themkoi/esp32-alarm-clock/clock-pcb/sub-boards/side-board/side-board.step

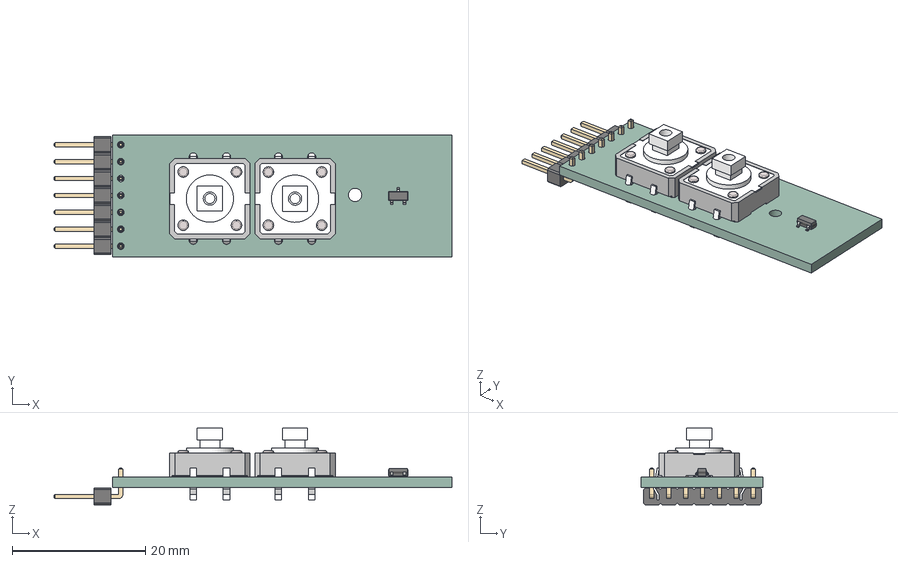
[picture p1: CAD file, 2025-02-12]
clock-pcb/sub-boards/side-board/side-board.step
59.8 x 18.3 x 11.5 mm
B3F-4055 x 2
SOT-23-3
PinHeader_1x07_P254mm_Horizontal
side-board_PCB
