themkoi/esp32-alarm-clock/clock-pcb/sub-boards/top-board/top-board.step

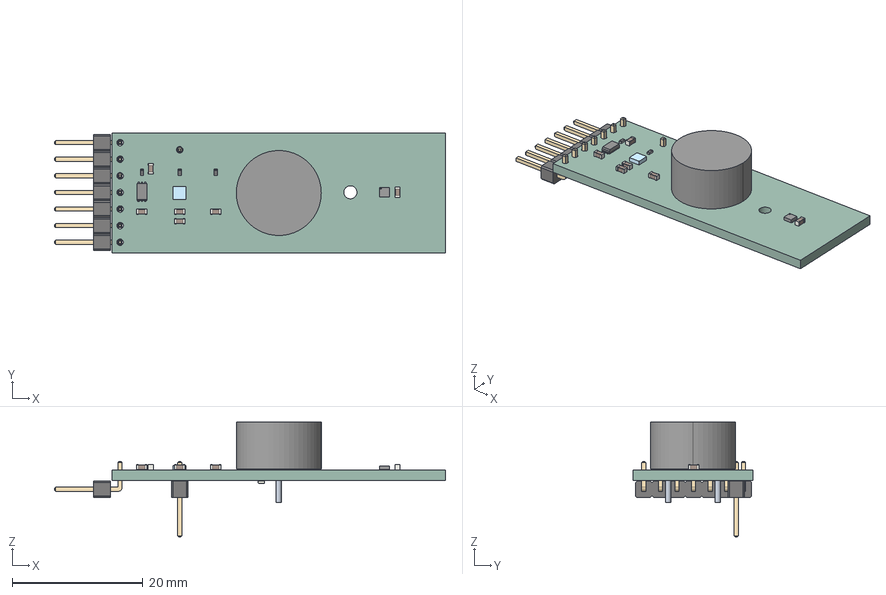
[picture p2: CAD file, 2025-02-12]
clock-pcb/sub-boards/top-board/top-board.step
59.8 x 18.3 x 17.5 mm
R_0402_1005Metric x 4
C_0603_1608Metric x 6
ASSEMBLY x 2
BH1750FVI-TR
PinHeader_1x01_P254mm_Vertical
PinHeader_1x07_P254mm_Horizontal
top-board_PCB
