themkoi/esp32-alarm-clock/clock-pcb/sub-boards/touch-pad/touch-pad.step

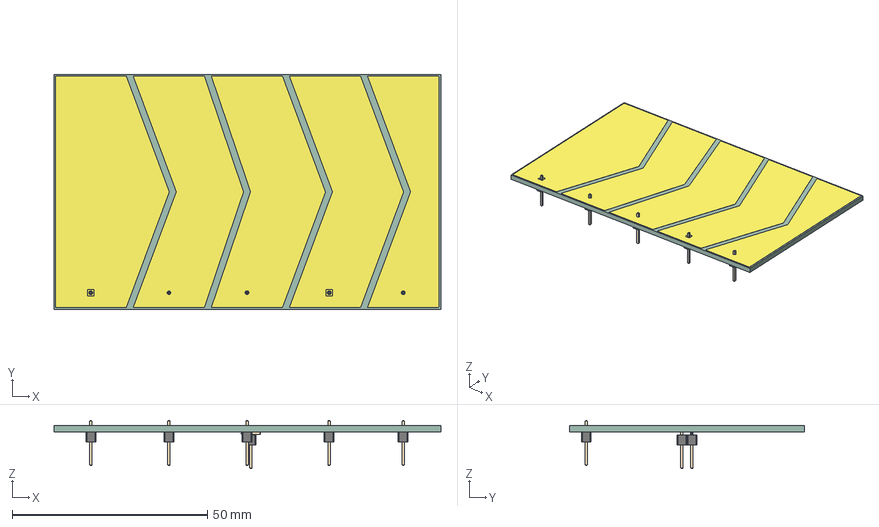
[picture p3: CAD file, 2025-02-12]
clock-pcb/sub-boards/touch-pad/touch-pad.step
99.0 x 60.0 x 12.3 mm
PinHeader_1x01_P254mm_Vertical x 5
PinHeader_1x02_P254mm_Vertical_SMD_Pin1Left
_autosave-touch-pad_track_1
_autosave-touch-pad_track_2
_autosave-touch-pad_track_3
_autosave-touch-pad_track_4
_autosave-touch-pad_track_5
_autosave-touch-pad_pad_1
_autosave-touch-pad_pad_2
_autosave-touch-pad_pad_3
_autosave-touch-pad_pad_4
_autosave-touch-pad_pad_5
_autosave-touch-pad_pad_6
_autosave-touch-pad_pad_7
_autosave-touch-pad_pad_8
_autosave-touch-pad_pad_9
_autosave-touch-pad_pad_10
_autosave-touch-pad_pad_11
_autosave-touch-pad_pad_12
_autosave-touch-pad_pad_13
_autosave-touch-pad_pad_14
_autosave-touch-pad_pad_15
_autosave-touch-pad_pad_16
_autosave-touch-pad_pad_17
_autosave-touch-pad_PCB
