themkoi/esp32-alarm-clock/clock-pcb/sub-boards/usb-board/usb-board.step

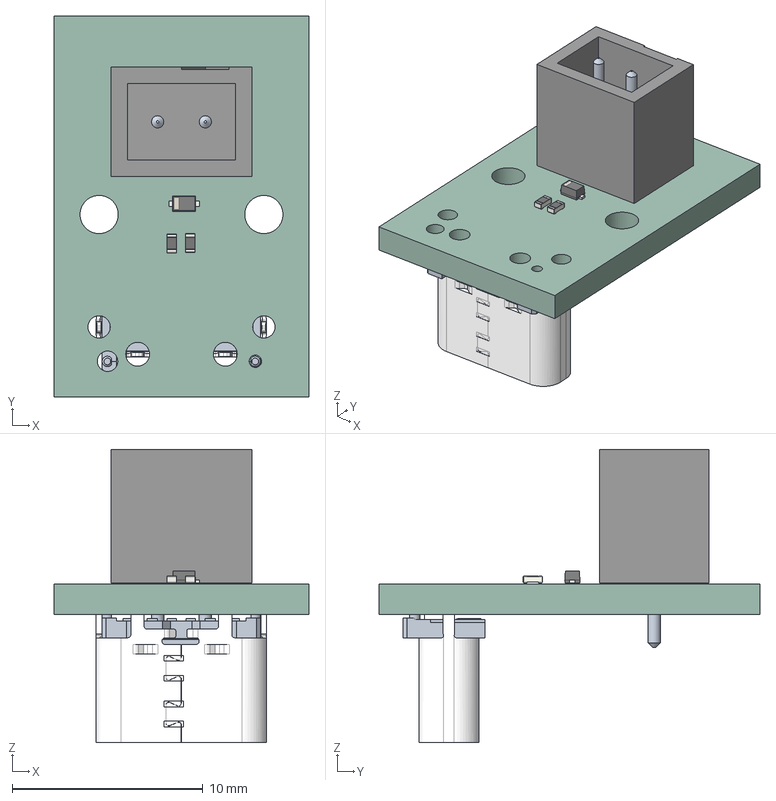
[picture p4: CAD file, 2025-02-12]
clock-pcb/sub-boards/usb-board/usb-board.step
13.4 x 20.0 x 15.4 mm
R_0402_1005Metric x 2
D_SOD_523
ASSEMBLY
USB4140-GF-0070-C
usb-board_PCB
