themkoi/esp32-alarm-clock/clock-pcb/sub-boards/side-board/side-board.kicad_pcb

## KiCad design clock-pcb/sub-boards/side-board/side-board.kicad_pcb (2025-02-12)

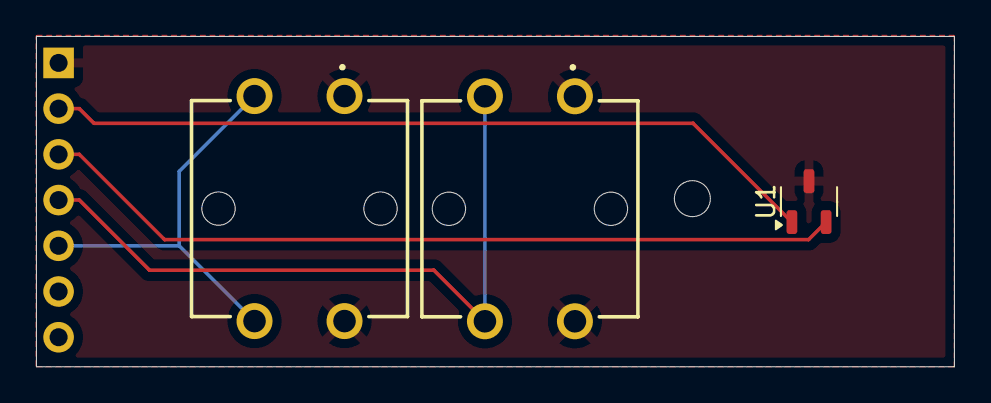
[picture p5: board side-board.kicad_pcb from above]

Board: 2 copper layers, 51.0 x 18.3 mm, 4 parts (1 on the bottom side), 5 nets.

Parts:
J1: Conn_01x07_Socket; PinHeader_1x07_P2.54mm_Horizontal
S1, S2: B3F-5050; B3F-4055
U1: TMAG5231C1GQDBZR; SOT-23-3

Connections:
+3V3: J1.2, U1.1 (VCC)
GND: J1.1, S1.1 (COM_1), S1.2 (COM_2), S2.1 (COM_1), S2.2 (COM_2), U1.3 (GND)
GPIO14: J1.4, S2.3 (NO_1), S2.4 (NO_2)
GPIO15: J1.5, S1.3 (NO_1), S1.4 (NO_2)
GPIO35: J1.3, U1.2 (OUT)
