themkoi/esp32-alarm-clock/clock-pcb/clock-pcb.kicad_pcb

## KiCad design clock-pcb/clock-pcb.kicad_pcb (2025-02-12)

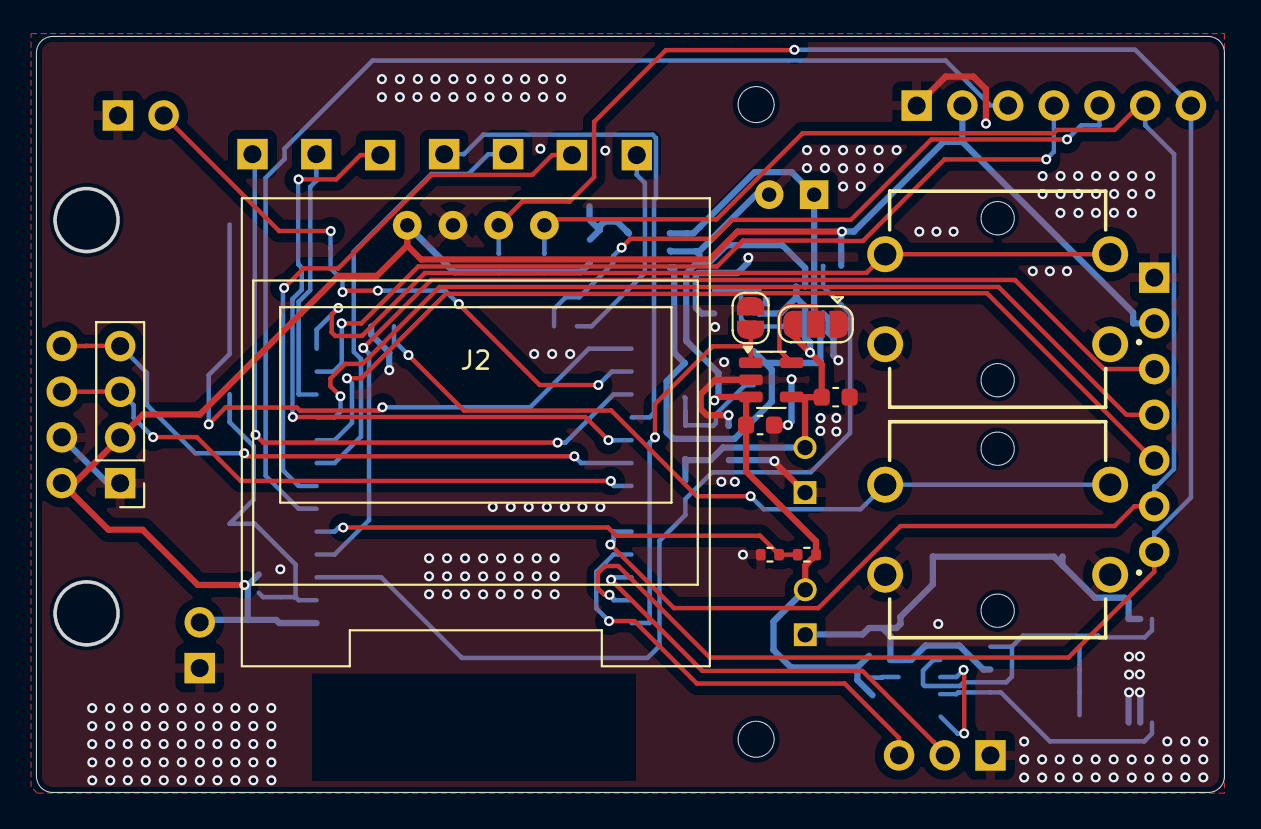
[picture p6: board clock-pcb.kicad_pcb from above]

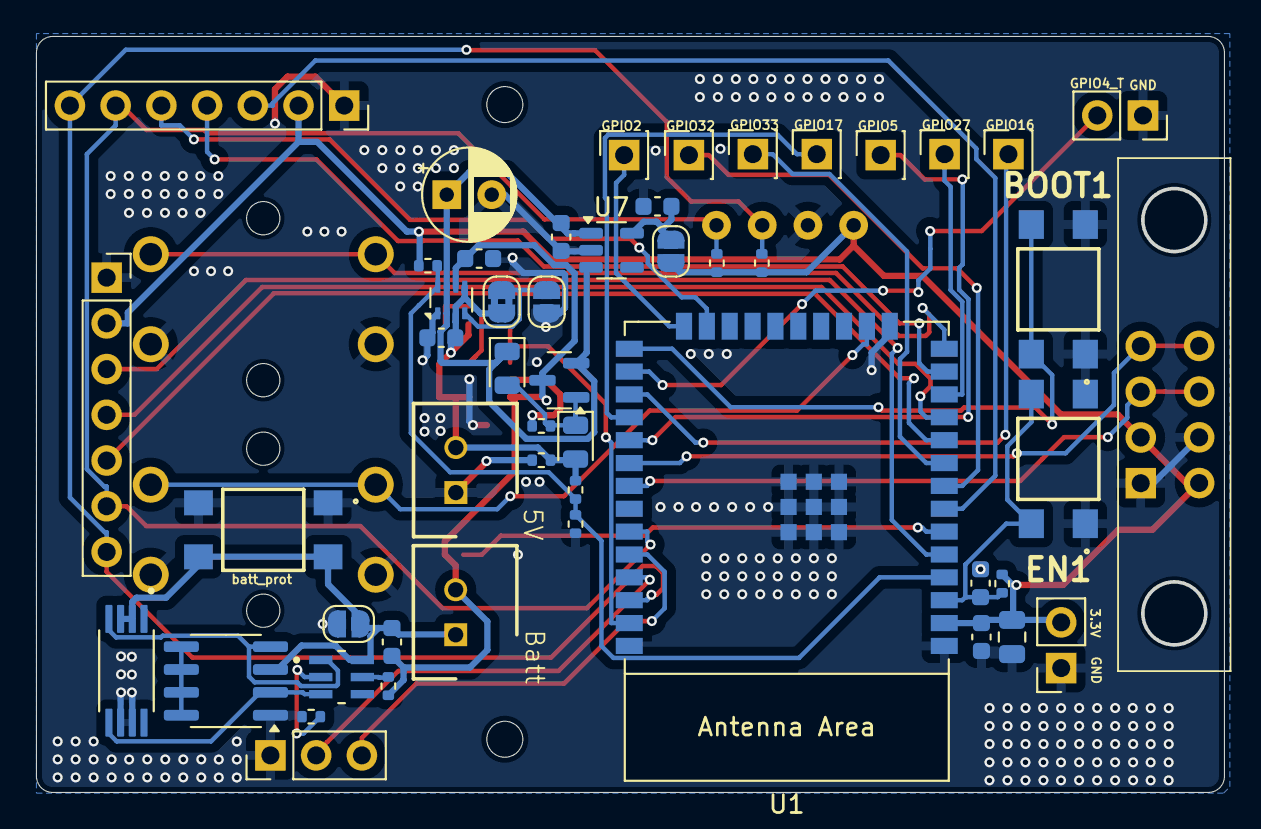
[picture p7: board clock-pcb.kicad_pcb from below]

Board: 2 copper layers, 66.0 x 42.0 mm, 61 parts (49 on the bottom side), 42 nets.

Parts:
AO9926C1: SOIC-8_3.9x4.9mm_P1.27mm
BATT_P1: TL3305AF160QG
BOOT1: TL3305AF160QG
C1: 22uF; C_0805_2012Metric
C2, C3, C4: 0.1uF; C_0603_1608Metric
C5: 100uF; CP_Radial_D5.0mm_P2.50mm
C6, C7, C8, C9, C10, C11: 1uF; C_0603_1608Metric
D3, D4: SD0805S040S0R5; D_0805_2012Metric
EN1: TL3305AF160QG
J1: Conn_01x03_Pin; PinHeader_1x03_P2.54mm_Vertical
J2: oled; SSD1306_0.96_Oled
J3: Led display; tm1637_module
J4: Led display 2; PinHeader_1x04_P2.54mm_Vertical
J5, J6: Conn_01x07_Socket; PinSocket_1x07_P2.54mm_Vertical
J7, J9, J10, J11, J12, J13, J14: Conn_01x01_Socket; PinSocket_1x01_P2.54mm_Vertical
J8, J15: Conn_01x02_Socket; PinSocket_1x02_P2.54mm_Vertical
JP1, JP2, JP7: Jumper; SolderJumper-2_P1.3mm_Open_RoundedPad1.0x1.5mm
JP3: Jumper_bridged; SolderJumper-2_P1.3mm_Bridged2Bar_RoundedPad1.0x1.5mm
JP4: SolderJumper_3_Open; SolderJumper-3_P1.3mm_Open_RoundedPad1.0x1.5mm
JP5: SolderJumper_2_Open; SolderJumper-2_P1.3mm_Open_RoundedPad1.0x1.5mm
Q1: FS8205A; SOP65P640X120-8N
Q2: FDN304PZ; SOT-23
R1: 10k; R_0402_1005Metric
R2: 300k; R_0402_1005Metric
R3, R10: 800k; R_0402_1005Metric
R4: 330R; R_0402_1005Metric
R5: 2.7K; R_0402_1005Metric
R6: 10K; R_0402_1005Metric
R7: 500k; R_0402_1005Metric
R8: 100K; R_0402_1005Metric
R9: 50k; R_0402_1005Metric
R11, R12: 5.1k; R_0402_1005Metric
S3, S4: B3F-5050; B3F-4055
U1: ESP32-WROOM-E; ESP32-WROOM-32E
U2: SOT95P280X140-6N
U3: SHDR2W64P0X250_1X2_740X575X700P
U4: TPS2116DRL; SOT-583-8
U5: MCP73811T-420I-OT; SOT-23-5
U7: TLV75533PDBV; SOT-23-5
USB_BOARD1: Conn_01x02_Socket; SHDR2W64P0X250_1X2_740X575X700P

Connections:
+3V3: C1.1, C2.1, J2.1, J3.4, J4.2, J5.2, J6.2, J15.2, JP7.2 (B), R1.1, R6.2, R11.1, R12.1, U1.2 (3V3)
+BATT: C4.2, C7.1, C11.1, Q2.3 (D), R2.1, R4.2, U3.2, U4.6 (VIN2), U5.3 (V_{BAT})
-BATT: AO9926C1.3 (S1), BATT_P1.3, BATT_P1.4, C4.1, JP1.1 (A), Q1.2, Q1.3, U2.6 (VSS), U3.1
ADC_BATT: R2.2, R3.1, U1.6 (GPIO34/ADC1_CH6)
BUTTON_DOWN: S4.3 (NO_1), S4.4 (NO_2), U1.16 (MTCK/GPIO13/ADC2_CH4)
BUTTON_UP: S3.3 (NO_1), S3.4 (NO_2), U1.14 (MTDI/GPIO12/ADC2_CH5)
CHARGE_EN: JP5.2 (B), U1.37 (GPIO23), U5.1 (CE)
CLK: J3.1, J4.4, U1.30 (GPIO18)
CO: AO9926C1.2 (G2), Q1.5, U2.3 (CO)
DIO: J3.2, J4.3, U1.31 (GPIO19)
DO: AO9926C1.4 (G1), Q1.4, U2.1 (DO)
EN: C3.2, EN1.3, EN1.4, R1.2, U1.3 (EN/CHIP_PU)
GND: AO9926C1.1 (S2), BATT_P1.1, BATT_P1.2, BOOT1.1, BOOT1.2, C1.2, C2.2, C3.1, C5.2, C6.1, C7.2, C8.2, C9.2, C10.2, C11.2, EN1.1, EN1.2, J1.1, J2.2, J3.3, J4.1, J5.1, J6.1, J8.1, J15.1, JP1.2 (B), JP2.1 (A), JP4.1 (A), JP5.1 (A), Q1.6, Q1.7, R3.2, R5.2, R8.2, R9.2, R10.2, S3.1 (COM_1), S3.2 (COM_2), S4.1 (COM_1), S4.2 (COM_2), U1.1 (GND), U1.15 (GND), U1.38 (GND), U1.39 (GND_THERMAL), U4.1 (GND), U5.2 (V_{SS}), U7.2 (GND), USB_BOARD1.1
GPIO4_T: J8.2, U1.26 (ADC2_CH0/GPIO4)
GPIO14: J5.4, U1.13 (MTMS/GPIO14/ADC2_CH6)
GPIO15: J5.5, U1.23 (MTDO/GPIO15/ADC2_CH3)
GPIO25: J6.5, U1.10 (DAC_1/ADC2_CH8/GPIO25)
GPIO26: J6.4, U1.11 (DAC_2/ADC2_CH9/GPIO26)
GPIO35: J5.3, U1.7 (GPIO35/ADC1_CH7)
GPIO39: J6.3, U1.5 (SENSOR_VN/GPIO39/ADC1_CH3)
IO0: BOOT1.3, BOOT1.4, U1.25 (GPIO0/BOOT/ADC2_CH1)
LDO_IN: C5.1, C9.1, D4.1 (K), Q2.2 (S), U4.2 (VOUT), U4.7 (VOUT), U7.1 (IN), U7.3 (EN)
unnamed: AO9926C1.5 (D1), AO9926C1.6 (D1), AO9926C1.7 (D2), AO9926C1.8 (D2)
unnamed: D3.1 (K), D4.2 (A), Q2.1 (G), R8.1
unnamed: J7.1, U1.8 (32K_XP/GPIO32/ADC1_CH4)
unnamed: J9.1, U1.29 (GPIO5)
unnamed: J10.1, U1.24 (ADC2_CH2/GPIO2)
unnamed: J11.1, U1.12 (ADC2_CH7/GPIO27)
unnamed: J12.1, U1.27 (GPIO16)
unnamed: J13.1, U1.28 (GPIO17)
unnamed: J14.1, U1.9 (32K_XN/GPIO33/ADC1_CH5)
unnamed: JP2.2 (B), JP3.1 (A), U4.4 (PR1)
unnamed: JP4.2 (C), U5.5 (PROG)
unnamed: C8.1, JP7.1 (A), U7.5 (OUT)
unnamed: R4.1, U2.5 (VDD)
unnamed: R5.1, U2.2 (VM)
POWER_STATUS: R6.1, R7.2, R10.1, U1.4 (SENSOR_VP/GPIO36/ADC1_CH0), U4.8 (ST)
RX: J1.3, U1.34 (U0RXD/GPIO3)
SCL: J2.3, J5.7, J6.7, R11.2, U1.36 (GPIO22)
SDA: J2.4, J5.6, J6.6, R12.2, U1.33 (GPIO21)
TX: J1.2, U1.35 (U0TXD/GPIO1)
VBUS: C6.2, C10.1, D3.2 (A), JP3.2 (B), JP4.3 (B), R7.1, R9.1, U4.3 (VIN1), U4.5 (MODE), U5.4 (V_{DD}), USB_BOARD1.2
