themkoi/esp32-alarm-clock/clock-pcb/sub-boards/top-board/top-board.kicad_pcb

## KiCad design clock-pcb/sub-boards/top-board/top-board.kicad_pcb (2025-02-12)

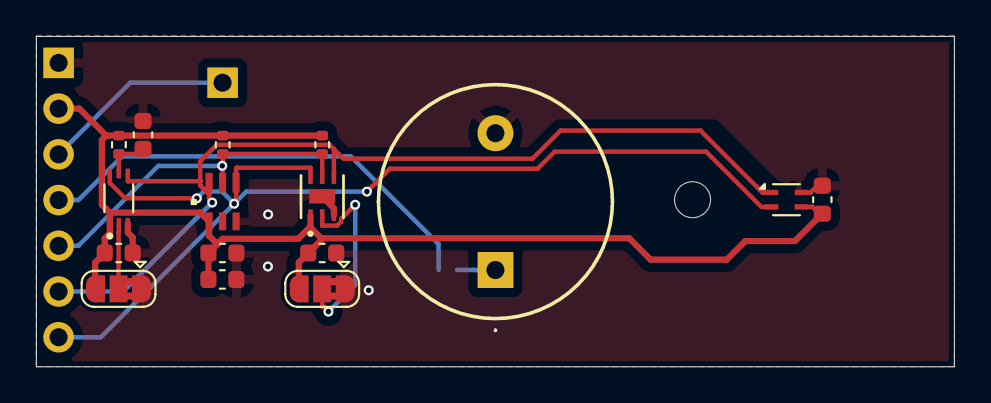
[picture p8: board top-board.kicad_pcb from above]

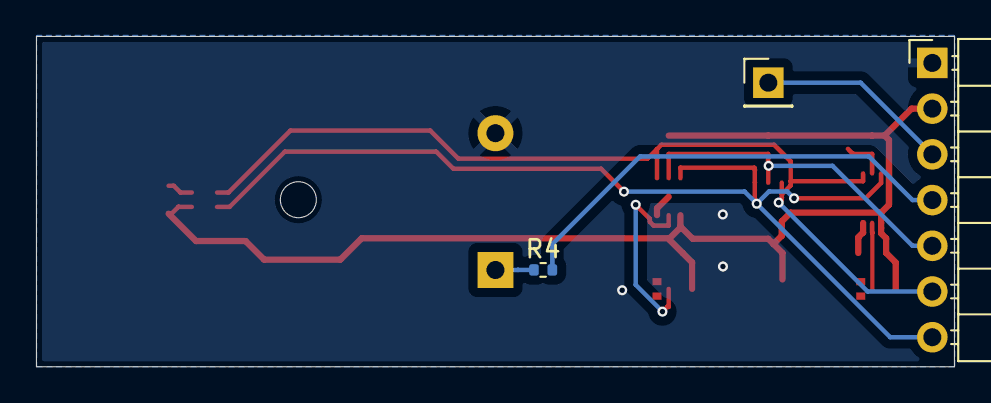
[picture p9: board top-board.kicad_pcb from below]

Board: 2 copper layers, 51.0 x 18.3 mm, 19 parts (3 on the bottom side), 11 nets.

Parts:
C1, C2, C3, C5, C6: 0.1uF; C_0603_1608Metric
C4: 4.7uF; C_0603_1608Metric
J1: Conn_01x07_Socket; PinHeader_1x07_P2.54mm_Horizontal
J2: Conn_01x01_Pin; PinHeader_1x01_P2.54mm_Vertical
JP1, JP2: SolderJumper_3_Bridged12; SolderJumper-3_P1.3mm_Bridged2Bar12_RoundedPad1.0x1.5mm
L1: CPT-14146-80T; CPT1414680T
R1: 1K; R_0402_1005Metric
R2, R3: 10K; R_0402_1005Metric
R4: 330R; R_0402_1005Metric
U1: BH1750FVI-TR; XDCR_BH1750FVI-TR
U2: LTR-F216A
U3: OPT3004DTSR; DNP6_TEX
U4: SHT4x; Sensirion_DFN-4_1.5x1.5mm_P0.8mm_SHT4x_NoCentralPad

Connections:
+3V3: C2.1, C3.1, C4.1, C5.1, C6.2, J1.2, JP1.3 (B), JP2.3 (B), R1.2, R2.1, R3.1, U1.1 (VCC), U2.1 (VDD), U3.1 (VDD), U4.3 (VDD)
GND: C1.2, C2.2, C3.2, C4.2, C5.2, C6.1, J1.1, JP1.1 (A), JP2.1 (A), L1.2, U1.3 (GND), U2.3 (GND), U3.3 (GND), U3.7 (EPAD), U4.4 (VSS)
GPIO25: J1.5, R2.2, R3.2, U2.5 (INT), U3.5 (INT)
GPIO26: J1.4, R4.2
GPIO39: J1.3, J2.1
unnamed: JP1.2 (C), U1.2 (ADDR)
unnamed: JP2.2 (C), U3.2 (ADDR)
unnamed: L1.1, R4.1
unnamed: C1.1, R1.1, U1.5 (DVI)
SCL: J1.7, U1.6 (SCL), U2.4 (SCL), U3.6 (SDA), U4.2 (SCL)
SDA: J1.6, U1.4 (SDA), U2.6 (SDA), U3.4 (SCL), U4.1 (SDA)
