themkoi/esp32-alarm-clock/code/src/lightSensor/lightSensor.h

#ifndef LIGHTSENSOR_H
#define LIGHTSENSOR_H

#include "../defines.h"

void createDimmingTask();

void dimLedDisplay();

float getLightLevel();
int smoothTouchRead(int pin);

bool checkForNight();

int getMmwaveState();

extern TaskHandle_t dimmingTaskHandle;
extern TaskHandle_t oledWakeupTaskHandle;
extern bool dimmingTaskRunning;
extern bool maxBrightness;
extern bool displayON;

extern bool inputDetected;
extern float lightLevel;


#endif
