themkoi/esp32-alarm-clock/code/src/WiFi/WiFi.cpp

#include "WiFi.h"

WiFiMulti wifiMulti;

TaskHandle_t wifiTask = NULL;
TaskStatus_t wifiTaskStatus;

void initWifi();
void WiFiEvent(WiFiEvent_t event);

bool WiFiTaskRunning = false;

bool tasksLaunched = false;
bool WifiOn = false;

void initWiFiHandle(void *parameter)
{
  while (true)
  {
    vTaskDelete(NULL);
  }
}

void initWifi()
{

  Serial.println("Starting Wifi Task");
  xTaskCreatePinnedToCore(
      initWiFiHandle, // Task function
      "WiFiTask",     // Task name
      4096,           // Stack size
      NULL,           // Task parameters
      2,              // Priority
      &wifiTask,      // Task handle
      0);
}

WiFiCred *wifiCredStatic[SIZE_WIFI_CRED_STAT];

void setWifiCountryCode()
{
#if WIFI_COUNTRY_FIX
  Serial.println("Setting wifi country code to: " + String(WIFI_COUNTRY_CODE));
  esp_wifi_set_country_code(WIFI_COUNTRY_CODE, !WIFI_COUNTRY_FORCE);
#endif
}

void tryToConnectWifi()
{
  Serial.println("sizeof(wifiCredStatic): " + String(SIZE_WIFI_CRED_STAT));
  for (int i = 0; i < SIZE_WIFI_CRED_STAT; i++)
  {
    if (wifiCredStatic[i] == NULL || wifiCredStatic[i]->ssid == NULL || wifiCredStatic[i]->password == NULL)
    {
      Serial.println("Skipping wifi id: " + String(i) + " because of null");
      continue;
    }
    else if (strlen(wifiCredStatic[i]->ssid) == 0 || strlen(wifiCredStatic[i]->password) < 8)
    {
      Serial.println("Skipping wifi id: " + String(i) + " because bad length");
      continue;
    }
    Serial.println("Trying to connect to wifi number: " + String(i) + " so: " + String(wifiCredStatic[i]->ssid) + " " + String(wifiCredStatic[i]->password));
    delay(100);
    setWifiCountryCode();
    WiFi.begin(wifiCredStatic[i]->ssid, wifiCredStatic[i]->password);
    setWifiCountryCode();

    for (int i = 0; i < WIFI_SYNC_TIME / 1000; i++)
    {
      delay(1000);
      if (WiFi.status() == WL_CONNECTED)
      {
        return;
      }
      else
      {
        Serial.println("Failed to connect to wifi...");
      }
    }
    if (WiFi.status() == WL_CONNECTED)
    {
      return;
    }
  }
}

void connectToWiFi(void *parameter)
{
  WifiOn = true;

  while (WifiOn)
  {
    WiFi.mode(WIFI_STA);
    WiFi.setSleep(WIFI_PS_MAX_MODEM);
    WiFi.setAutoReconnect(true);

    WiFiTaskRunning = true;

    esp_wifi_start();

    if (readOtaValue() == false && tasksLaunched == false)
    {
      WiFi.onEvent(WiFiEvent);
    }

    Serial.println("Connecting to WiFi");

    // Add predefined WiFi credentials
    wifiCredStatic[0] = new WiFiCred{SSID1, PASSWORD1};
    wifiCredStatic[1] = new WiFiCred{SSID2, PASSWORD2};
    wifiCredStatic[2] = new WiFiCred{SSID3, PASSWORD3};

    // Call tryToConnectWifi to handle the connection attempts
    tryToConnectWifi();

    if (WiFi.status() == WL_CONNECTED)
    {
      Serial.println("\nConnected to WiFi");
      Serial.print("Got IP: ");
      Serial.println(WiFi.localIP());
      Serial.println("Mac Address: " + String(WiFi.macAddress()));
      break; // Exit the loop after successful connection
    }
    else
    {
      Serial.println("Failed to connect to any WiFi network. Retrying...");
    }

    vTaskDelay(30000 / portTICK_PERIOD_MS); // Wait before retrying
  }

  WiFiTaskRunning = false;
  vTaskDelete(NULL);
}

void createWifiTask()
{
  wifi_init_config_t wifi_init_config = WIFI_INIT_CONFIG_DEFAULT();

  esp_err_t ret = esp_wifi_init(&wifi_init_config);
  xTaskCreatePinnedToCore(
      connectToWiFi, // Task function
      "WiFiTask",    // Task name
      4096,         // Stack size
      NULL,          // Task parameters
      10,            // Priority
      &wifiTask,     // Task handle
      0);            // Core (0 or 1)
}

bool isWifiTaskCheck()
{
  bool tmp = WiFiTaskRunning;
  return tmp;
}

void turnOffWifiMinimal()
{
  if (WiFi.getMode() != WIFI_OFF)
  {
    if (WiFi.disconnect(true) == false)
    {
      Serial.println("Failed to disconnect from wifi? turning it off anyway");
      if (WiFi.mode(WIFI_OFF) == false)
      {
        Serial.println("Failed to force set mode of wifi, doing manual esp idf way");
      }
    }
  }
}

void turnOffWifi()
{
  WifiOn = false;
  Serial.println("Turning wifi off");
  if (WiFi.status() == WL_CONNECTED)
  {
    while (WiFiTaskRunning == true)
    {
      vTaskDelay(30);
      Serial.println("WiFi Task running watiting for it to complete");
    }

    while (WiFi.scanComplete() == WIFI_SCAN_RUNNING)
    {
      Serial.println("WiFi Scan running watiting for it to complete");
      vTaskDelay(30);
    }
    // vTaskSuspend(wifiTask);
    // delay(1500);
  }
  esp_wifi_stop();
}
void WiFiEvent(WiFiEvent_t event)
{
  Serial.println("WiFi event");

  // Declare WiFiTaskState outside the switch block
  eTaskState WiFiTaskState;

  switch (event)
  {
  case ARDUINO_EVENT_WIFI_STA_GOT_IP:
    Serial.println("WiFi got IP");
    if (tasksLaunched == false)
    {
      delay(4000);
      Serial.println("Launching Tasks");
      synchronizeAndSetTime();
      Serial.println("Synchronized Time");
      delay(1000);
      createWeatherTask();
      int currentHour = hour();
      int currentMinute = minute();
      LedDisplay.showNumberDecEx(currentHour * 100 + currentMinute, 0b11100000, true);
      tasksLaunched = true;
    }
    break;

  case ARDUINO_EVENT_WIFI_STA_DISCONNECTED:
    WiFiTaskState = eTaskGetState(wifiTask); // Assign the task state here
    if (powerConnected == true)
    {
      turnOffWifi();
    }
    if (!WiFi.isConnected() && WiFiTaskRunning == false && powerConnected == true)
    {
      esp_wifi_start();
      Serial.println("launching WiFi task");
      createWifiTask();
    }
    break;

  case ARDUINO_EVENT_PROV_CRED_FAIL:
    WiFiTaskState = eTaskGetState(wifiTask); // Assign the task state here
    if (powerConnected == true)
    {
      turnOffWifi();
    }
    if (!WiFi.isConnected() && WiFiTaskRunning == false && powerConnected == true)
    {
      esp_wifi_start();
      Serial.println("launching WiFi task");
      createWifiTask();
    }
    break;
  case ARDUINO_EVENT_WIFI_STA_LOST_IP:
    WiFiTaskState = eTaskGetState(wifiTask); // Assign the task state here
    if (powerConnected == true)
    {
      turnOffWifi();
    }
    if (!WiFi.isConnected() && WiFiTaskRunning == false && powerConnected == true)
    {
      esp_wifi_start();
      Serial.println("launching WiFi task");
      createWifiTask();
    }
    break;

  default:
    break;
  }
}
