themkoi/esp32-alarm-clock/code/src/oledDisplay/interface.h

#ifndef INTERFACE_H
#define INTERFACE_H

#include "../defines.h"

void initMenus();
void handleMenus();
void showMenu();

void addNewAlarm();

bool shouldExitLoop();
void resetToDefaultMenu();

extern bool menuRunning;
extern bool idleEnabled;
extern bool exitLoopFunction;

extern TaskHandle_t menuTaskHandle;

#endif
