themkoi/esp32-alarm-clock/code/src/confidential-template.h

#ifndef CONFIDENTIAL_H
#define CONFIDENTIAL_H

// Wifi
#define SSID1 ""
#define PASSWORD1 ""
#define SSID2 ""
#define PASSWORD2 ""
#define SSID3 ""
#define PASSWORD3 ""

#define LIGHT_GATE ""
#define LIGHT_IP ""

// Weather
#define WEATHER_LATIT
#define WEATHER_LONGTIT

#endif
