themkoi/esp32-alarm-clock/(commit log)

2025-02-12 support for touch "slider"
    [LTR-F216A.step, clock-pcb.kicad_pcb, side-board.kicad_pcb, side-board.step, top-board.kicad_pcb, top-board.step, touch-pad.step, usb-board.step]
2025-02-12 les lag on screensaver
2025-02-13 fix stupid bug of not chaning alarm menu
    [interface.cpp, interface.h, menus.cpp]
2025-02-13 make input detection more responsive and led brightness
2025-02-20 fix dimming sometimes not working
    [lightSensor.cpp]
2025-02-24 fixing some bugs writing comments and cleaning up
    [defines.h, lightSensor.cpp]
2025-03-23 "fixed" weather not working sometimes and more responsive display wakeup
    [OpenMeteo.cpp, OpenMeteo.h, lightSensor.cpp, lightSensor.h, weather.cpp, weather.h]
2025-03-23 adjust behavior on battery
2025-03-29 better battery stuff
2025-05-17 littlefs some bug fixes alarm interface fix
    [Flash.cpp, defines.h, hardware.cpp, interface.cpp, interface.h, lightSensor.cpp, main.cpp, menus.cpp]
2025-05-18 working buttons
2025-05-19 led display
2025-05-19 ui fix interface fix holding support
    [interface.cpp, lightSensor.cpp, mainPage.cpp]
2025-05-19 continue even if something goes wrong
    [hardware.cpp, main.cpp, mainPage.cpp, touch.cpp]
2025-06-12 fix battery managment still need to recabrate touch
    [battery.cpp, defines.h, lightSensor.cpp, mainPage.cpp, touch.cpp]
2025-07-02 general fixes and clean up
    [Flash.cpp, WiFi.cpp, defines.h, hardware.cpp, interface.cpp, lightSensor.cpp, main.cpp]
2025-07-02 fix turning off alarm I think
    [alarms.cpp]
